PoringH/QCK75-XT/WhatsApp Image 2023-07-01 at 13.19.53.jpg

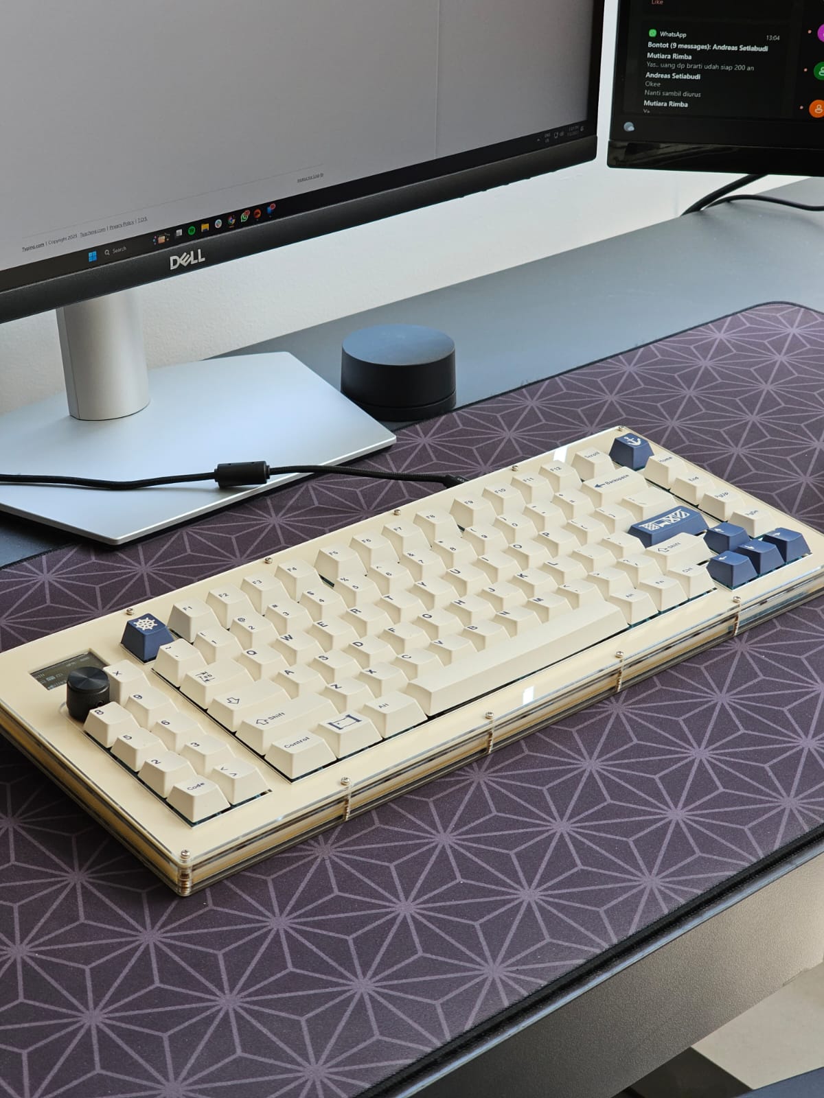
WhatsApp Image 2023-07-01 at 13.19.53.jpg
