PoringH/QCK75-XT/Photos/673584.jpg

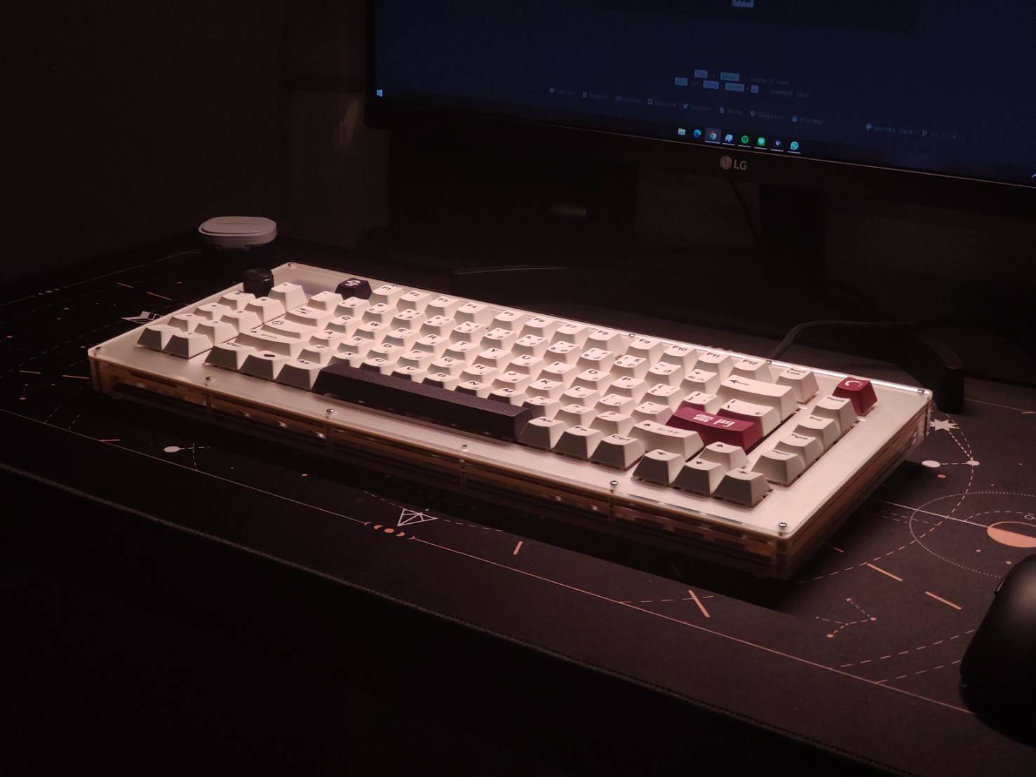
Photos/673584.jpg
