PoringH/QCK75-XT/Photos/673581.jpg

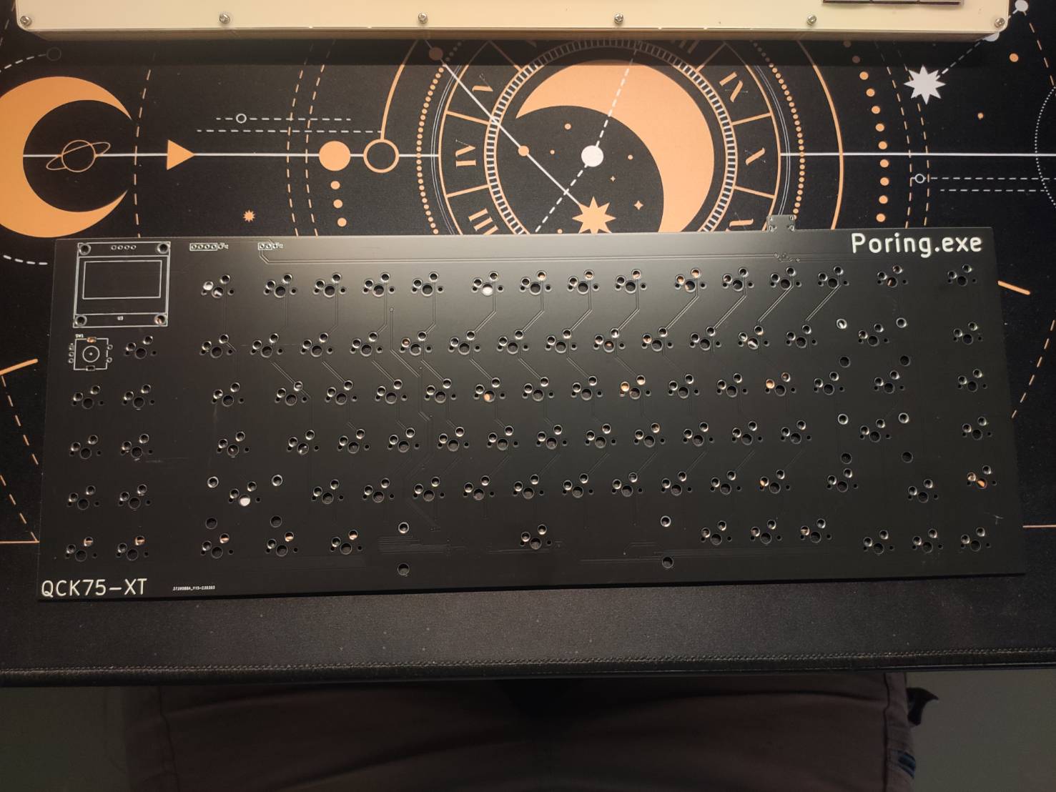
Photos/673581.jpg
