PoringH/QCK75-XT/Photos/673582.jpg

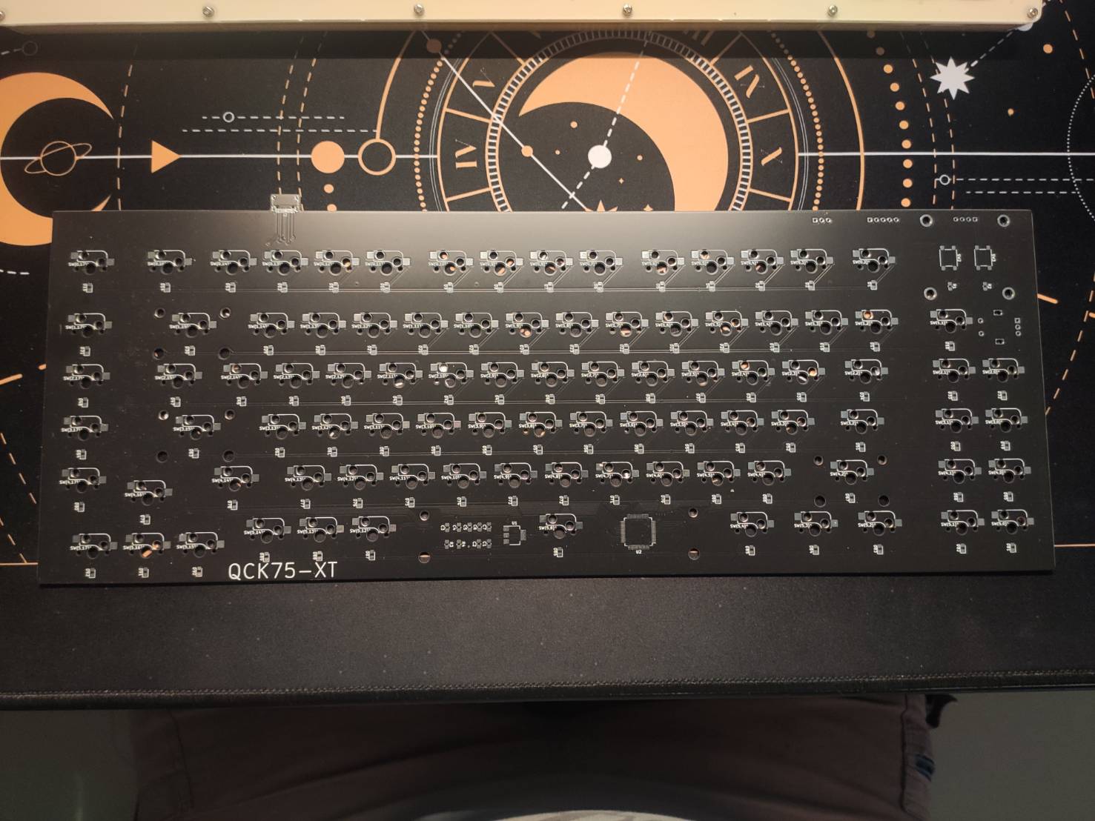
Photos/673582.jpg
