PoringH/QCK75-XT/Photos/673583.jpg

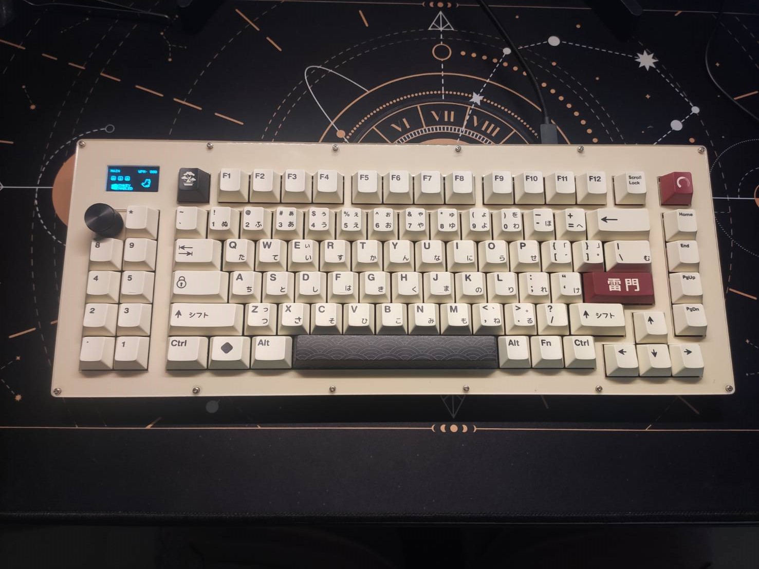
Photos/673583.jpg
