PoringH/QCK75-XT/Photos/673585.jpg

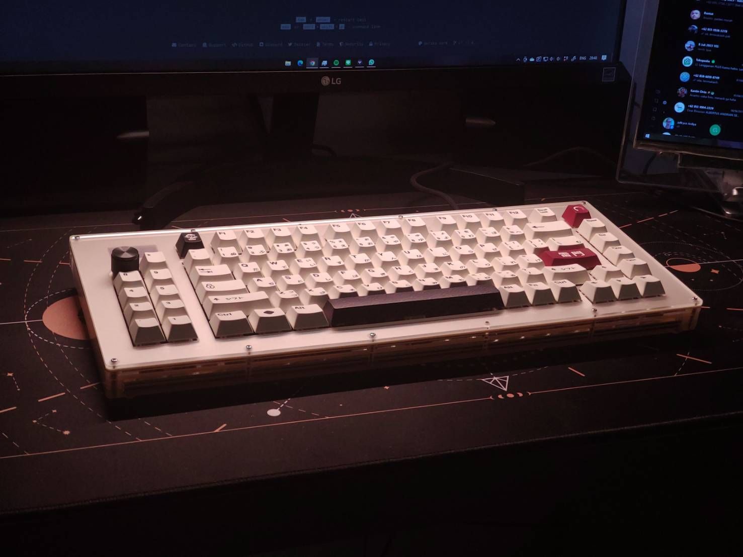
Photos/673585.jpg
