PoringH/QCK75-XT/Photos/673586.jpg

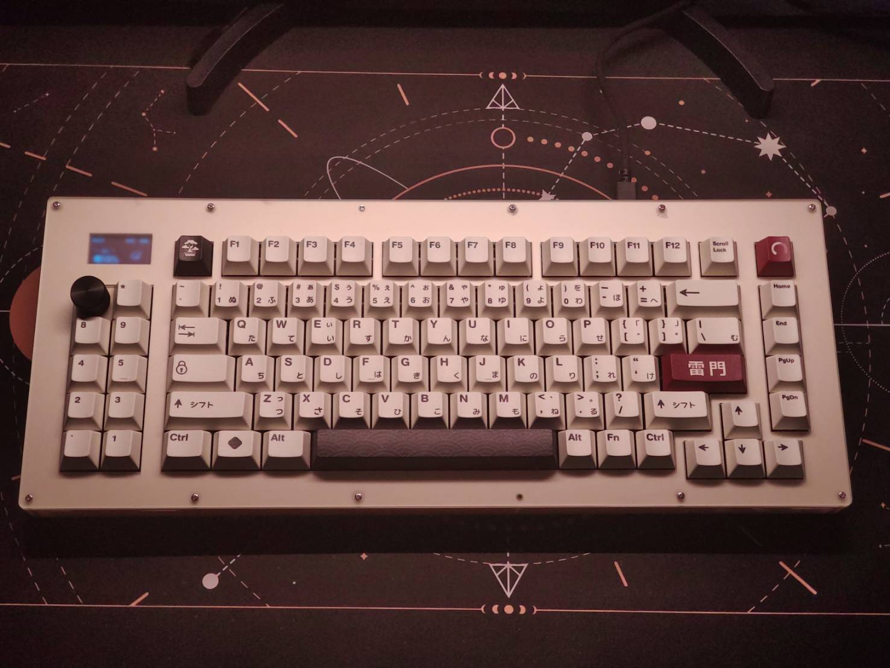
Photos/673586.jpg
