PoringH/QCK75-XT/QCK75 Kicad v2/QCK.csv

Source: | D:\File Andrian\Keeb\QCK75-XT\QCK.kicad_sch
Date: | 20/03/2023 19:50:19
Tool: | Eeschema (6.0.11)
Generator: | C:\Program Files\KiCad\6.0\bin\scripting\plugins/bom_csv_grouped_by_value.py
Component Count: | 208
Individual Components:
Item | Qty | Reference(s) | Value | LibPart | Footprint | Datasheet
 |  | C1 | 100nF | Device:C | Capacitor_SMD:C_0805_2012Metric_Pad1.18x1.45mm_HandSolder | ~
 |  | C2 | 10uF | Device:C | Capacitor_SMD:C_0805_2012Metric_Pad1.18x1.45mm_HandSolder | ~
 |  | C3 | 4.7uF | Device:C | Capacitor_SMD:C_0805_2012Metric_Pad1.18x1.45mm_HandSolder | ~
 |  | C4 | 100nF | Device:C | Capacitor_SMD:C_0805_2012Metric_Pad1.18x1.45mm_HandSolder | ~
 |  | C5 | 100nF | Device:C | Capacitor_SMD:C_0805_2012Metric_Pad1.18x1.45mm_HandSolder | ~
 |  | C6 | 100nF | Device:C | Capacitor_SMD:C_0805_2012Metric_Pad1.18x1.45mm_HandSolder | ~
 |  | C7 | 100nF | Device:C | Capacitor_SMD:C_0805_2012Metric_Pad1.18x1.45mm_HandSolder | ~
 |  | D1 | D | Device:D | Diode_SMD:D_0805_2012Metric_Pad1.15x1.40mm_HandSolder | ~
 |  | D2 | D | Device:D | Diode_SMD:D_0805_2012Metric_Pad1.15x1.40mm_HandSolder | ~
 |  | D3 | D | Device:D | Diode_SMD:D_0805_2012Metric_Pad1.15x1.40mm_HandSolder | ~
 |  | D4 | D | Device:D | Diode_SMD:D_0805_2012Metric_Pad1.15x1.40mm_HandSolder | ~
 |  | D5 | D | Device:D | Diode_SMD:D_0805_2012Metric_Pad1.15x1.40mm_HandSolder | ~
 |  | D6 | D | Device:D | Diode_SMD:D_0805_2012Metric_Pad1.15x1.40mm_HandSolder | ~
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
 |  | SW(5,13)1 | MX_SW_HS | marbastlib-mx:MX_SW_HS | marbastlib-mx:SW_MX_HS_1u | ~
 |  | SW(5,14)1 | MX_SW_HS | marbastlib-mx:MX_SW_HS | marbastlib-mx:SW_MX_HS_1u | ~
 |  | SW(5,15)1 | MX_SW_HS | marbastlib-mx:MX_SW_HS | marbastlib-mx:SW_MX_HS_1u | ~
 |  | SW(5,16)1 | MX_SW_HS | marbastlib-mx:MX_SW_HS | marbastlib-mx:SW_MX_HS_1u | ~
 |  | SW(5,17)1 | MX_SW_HS | marbastlib-mx:MX_SW_HS | marbastlib-mx:SW_MX_HS_1u | ~
 |  | U1 | AMS1117-3.3 | Regulator_Linear:AMS1117-3.3 | Package_TO_SOT_SMD:SOT-223-3_TabPin2 | http://www.advanced-monolithic.com/pdf/ds1117.pdf
 |  | U2 | STM32F072R8Tx | MCU_ST_STM32F0:STM32F072R8Tx | Package_QFP:LQFP-64_10x10mm_P0.5mm | http://www.st.com/st-web-ui/static/active/en/resource/technical/document/datasheet/DM00090510.pdf
 |  | U3 | SSD1306_128X64 | marbastlib-mx:SSD1306_128X64 | marbastlib-mx:SSD1306_128X64
Collated Components:
Item | Qty | Reference(s) | Value | LibPart | Footprint | Datasheet
1 | 5 | C1, C4, C5, C6, C7 | 100nF | Device:C | Capacitor_SMD:C_0805_2012Metric_Pad1.18x1.45mm_HandSolder | ~
2 | 1 | C2 | 10uF | Device:C | Capacitor_SMD:C_0805_2012Metric_Pad1.18x1.45mm_HandSolder | ~
3 | 1 | C3 | 4.7uF | Device:C | Capacitor_SMD:C_0805_2012Metric_Pad1.18x1.45mm_HandSolder | ~
4 | 92 | D1, D2, D3, D4, D5, D6, D7, D8, D9, D10, D11, D12, D13, D14, D15, D16, D17, D18, D19, D20, D21, D22, D23, D24, D25, D26, D27, D28, D29, D30, D31, D32, D33, D34, D35, D36, D37, D38, D39, D40, D41, D42, D43, D44, D45, D46, D47, D48, D49, D50, D51, D52, D53, D54, D55, D56, D57, D58, D59, D60, D61, D62, D63, D64, D65, D66, D67, D68, D69, D70, D71, D72, D73, D74, D75, D76, D77, D78, D79, D80, D81, D82, D83, D84, D85, D86, D87, D88, D89, D90, D91, D92 | D | Device:D | Diode_SMD:D_0805_2012Metric_Pad1.15x1.40mm_HandSolder | ~
5 | 1 | J1 | Conn_01x05_Female | Connector:Conn_01x05_Female | Connector_PinHeader_2.54mm:PinHeader_1x05_P2.54mm_Vertical | ~
6 | 1 | J2 | USB_C_Receptacle_USB2.0 | Connector:USB_C_Receptacle_USB2.0 | Connector_USB:USB_C_Receptacle_HRO_TYPE-C-31-M-12 | https://www.usb.org/sites/default/files/documents/usb_type-c.zip
7 | 1 | J3 | Conn_01x03_Female | Connector:Conn_01x03_Female | Connector_PinHeader_2.54mm:PinHeader_1x03_P2.54mm_Vertical | ~
8 | 4 | R1, R2, R3, R4 | 5.1k | Device:R | Resistor_SMD:R_0805_2012Metric_Pad1.20x1.40mm_HandSolder | ~
9 | 1 | S(1,15)1 | MX_stab | marbastlib-mx:MX_stab | marbastlib-mx:STAB_MX_P_2u
10 | 2 | S(3,15)1, S(4,2)1 | MX_stab | marbastlib-mx:MX_stab | marbastlib-mx:STAB_MX_P_2.25u
11 | 1 | S(5,8)1 | MX_stab | marbastlib-mx:MX_stab | marbastlib-mx:STAB_MX_P_6.25u
12 | 1 | SW1 | RotaryEncoder_Switch | Device:RotaryEncoder_Switch | Rotary_Encoder:RotaryEncoder_Alps_EC11E-Switch_Vertical_H20mm | ~
13 | 2 | SW2, SW3 | SW_Push | Switch:SW_Push | Button_Switch_SMD:SW_Push_1P1T_NO_6x6mm_H9.5mm | ~
14 | 85 | SW(0,2)1, SW(0,3)1, SW(0,4)1, SW(0,5)1, SW(0,6)1, SW(0,7)1, SW(0,8)1, SW(0,9)1, SW(0,10)1, SW(0,11)1, SW(0,12)1, SW(0,13)1, SW(0,14)1, SW(0,16)1, SW(0,17)1, SW(1,1)1, SW(1,2)1, SW(1,3)1, SW(1,4)1, SW(1,5)1, SW(1,6)1, SW(1,7)1, SW(1,8)1, SW(1,9)1, SW(1,10)1, SW(1,11)1, SW(1,12)1, SW(1,13)1, SW(1,14)1, SW(1,15)1, SW(1,17)1, SW(2,0)1, SW(2,1)1, SW(2,3)1, SW(2,4)1, SW(2,5)1, SW(2,6)1, SW(2,7)1, SW(2,8)1, SW(2,9)1, SW(2,10)1, SW(2,11)1, SW(2,12)1, SW(2,13)1, SW(2,14)1, SW(2,17)1, SW(3,0)1, SW(3,1)1, SW(3,3)1, SW(3,4)1, SW(3,5)1, SW(3,6)1, SW(3,7)1, SW(3,8)1, SW(3,9)1, SW(3,10)1, SW(3,11)1, SW(3,12)1, SW(3,13)1, SW(3,15)1, SW(3,17)1, SW(4,0)1, SW(4,1)1, SW(4,2)1, SW(4,4)1, SW(4,5)1, SW(4,6)1, SW(4,7)1, SW(4,8)1, SW(4,9)1, SW(4,10)1, SW(4,11)1, SW(4,12)1, SW(4,13)1, SW(4,16)1, SW(4,17)1, SW(5,0)1, SW(5,1)1, SW(5,8)1, SW(5,12)1, SW(5,13)1, SW(5,14)1, SW(5,15)1, SW(5,16)1, SW(5,17)1 | MX_SW_HS | marbastlib-mx:MX_SW_HS | marbastlib-mx:SW_MX_HS_1u | ~
15 | 2 | SW(2,2)1, SW(2,15)1 | MX_SW_HS | marbastlib-mx:MX_SW_HS | marbastlib-mx:SW_MX_HS_1.5u | ~
16 | 2 | SW(3,2)1, SW(4,14)1 | MX_SW_HS | marbastlib-mx:MX_SW_HS | marbastlib-mx:SW_MX_HS_1.75u | ~
17 | 3 | SW(5,2)1, SW(5,3)1, SW(5,4)1 | MX_SW_HS | marbastlib-mx:MX_SW_HS | marbastlib-mx:SW_MX_HS_1.25u | ~
18 | 1 | U1 | AMS1117-3.3 | Regulator_Linear:AMS1117-3.3 | Package_TO_SOT_SMD:SOT-223-3_TabPin2 | http://www.advanced-monolithic.com/pdf/ds1117.pdf
19 | 1 | U2 | STM32F072R8Tx | MCU_ST_STM32F0:STM32F072R8Tx | Package_QFP:LQFP-64_10x10mm_P0.5mm | http://www.st.com/st-web-ui/static/active/en/resource/technical/document/datasheet/DM00090510.pdf
20 | 1 | U3 | SSD1306_128X64 | marbastlib-mx:SSD1306_128X64 | marbastlib-mx:SSD1306_128X64
