PoringH/QCK75-XT/Freecad/alu case/test.step

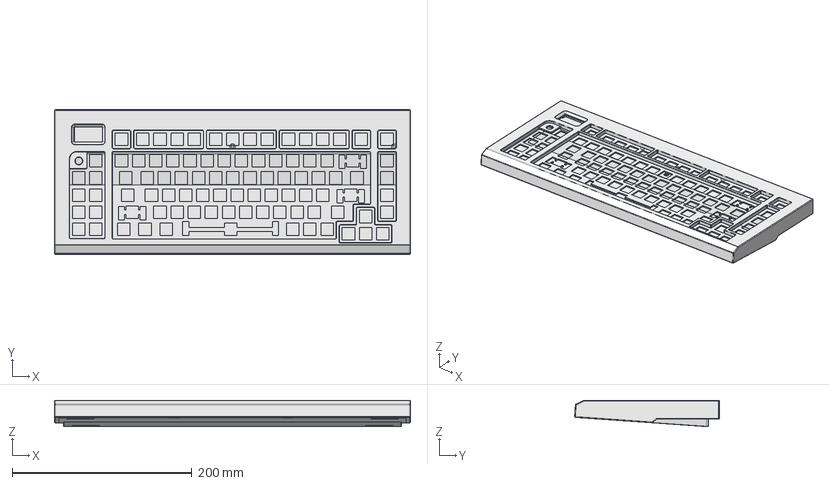
[picture p8: CAD file, 2023-08-31]
Freecad/alu case/test.step
395.9 x 161.1 x 29.4 mm
