PoringH/QCK75-XT/Freecad/pcb.step

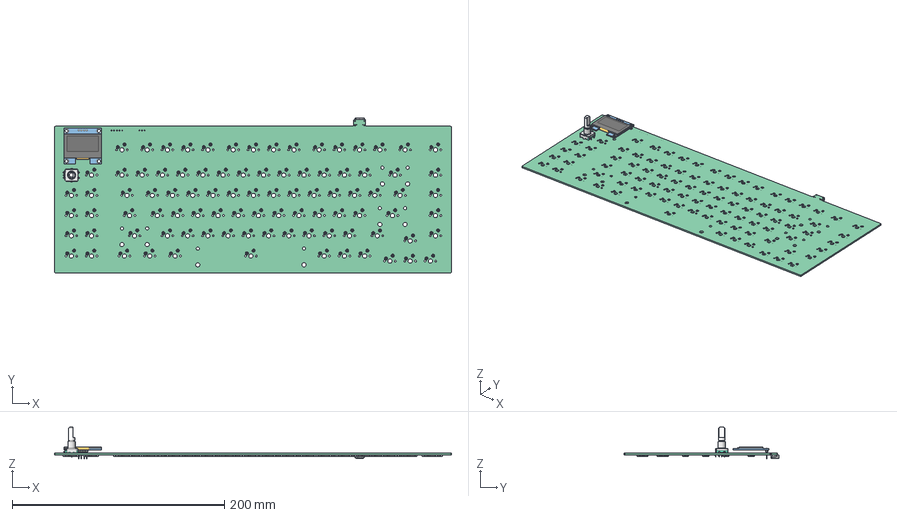
[picture p9: CAD file, 2023-08-31]
Freecad/pcb.step
373.9 x 145.8 x 30.0 mm
Local_CS_c8ce
Pcb_c8ce
PCB_Sketch_c8ce
U3_AZ-Delivery - OLED13 IIC_5770bfb8a0b9
SW1_(Unsaved)_ded8dcd7eb34
Contact x 188
USB_C_Receptacle_16P_TopMnt_Horizontal_GCT_USB4105-xx-A
