PoringH/QCK75-XT/Freecad/alu case/topcase.step

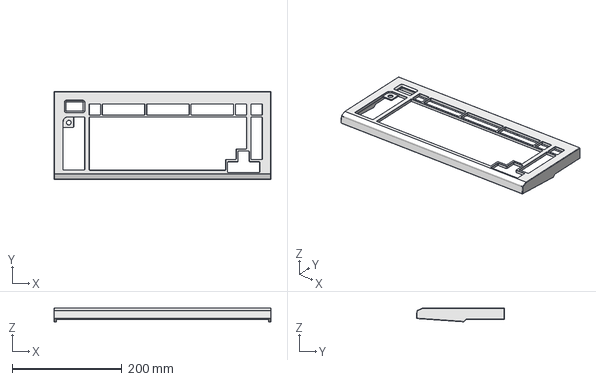
[picture p10: CAD file, 2023-06-27]
Freecad/alu case/topcase.step
395.9 x 161.1 x 25.1 mm
