PoringH/QCK75-XT/Freecad/QCK.FCStd

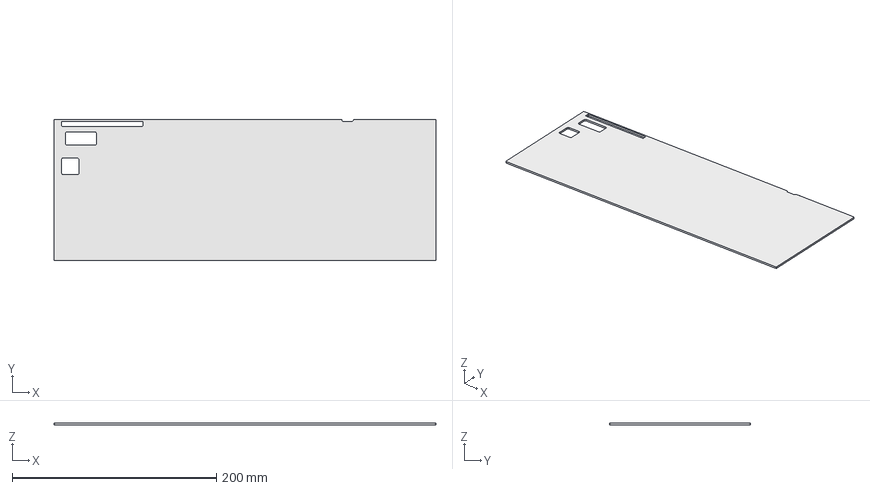
[picture p11: CAD file, 2023-08-31]
Freecad/QCK.FCStd
373.9 x 138.1 x 2.00 mm
