PoringH/QCK75-XT/Freecad/2mm_putih tulang_801.dxf

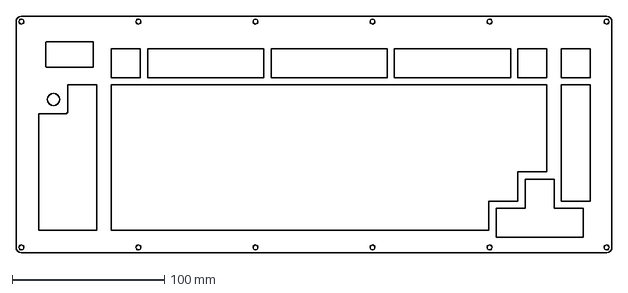
[picture p12: CAD file, 2023-05-16]
Freecad/2mm_putih tulang_801.dxf
390.9 x 155.1 mm
