PoringH/QCK75-XT/Freecad/alu case/weight.step

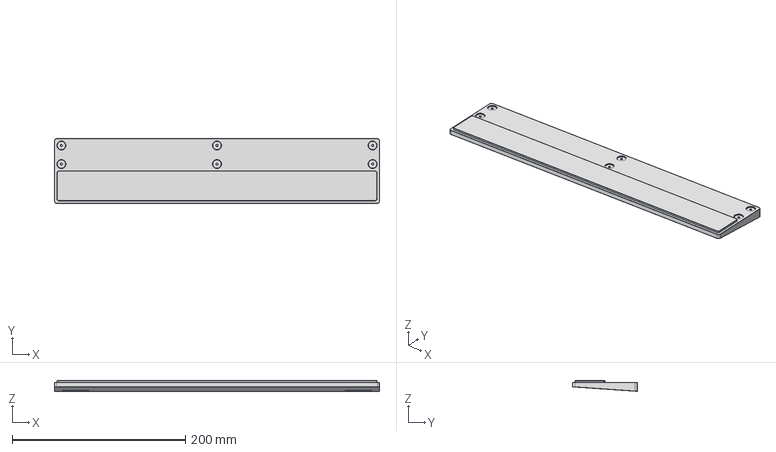
[picture p13: CAD file, 2023-06-27]
Freecad/alu case/weight.step
375.4 x 74.8 x 12.4 mm
