PoringH/QCK75-XT/Freecad/alu case/bottomcase.step

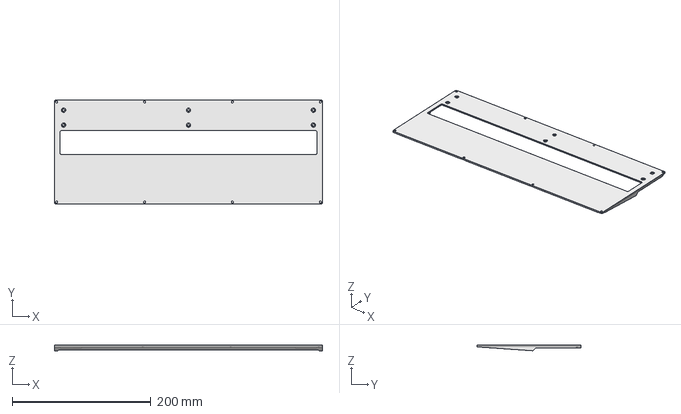
[picture p14: CAD file, 2023-06-27]
Freecad/alu case/bottomcase.step
385.8 x 150.0 x 8.05 mm
