PoringH/QCK75-XT/QCK75 Kicad v2/QCK.kicad_sch

## KiCad design QCK75 Kicad v2/QCK.kicad_sch (2023-03-02)

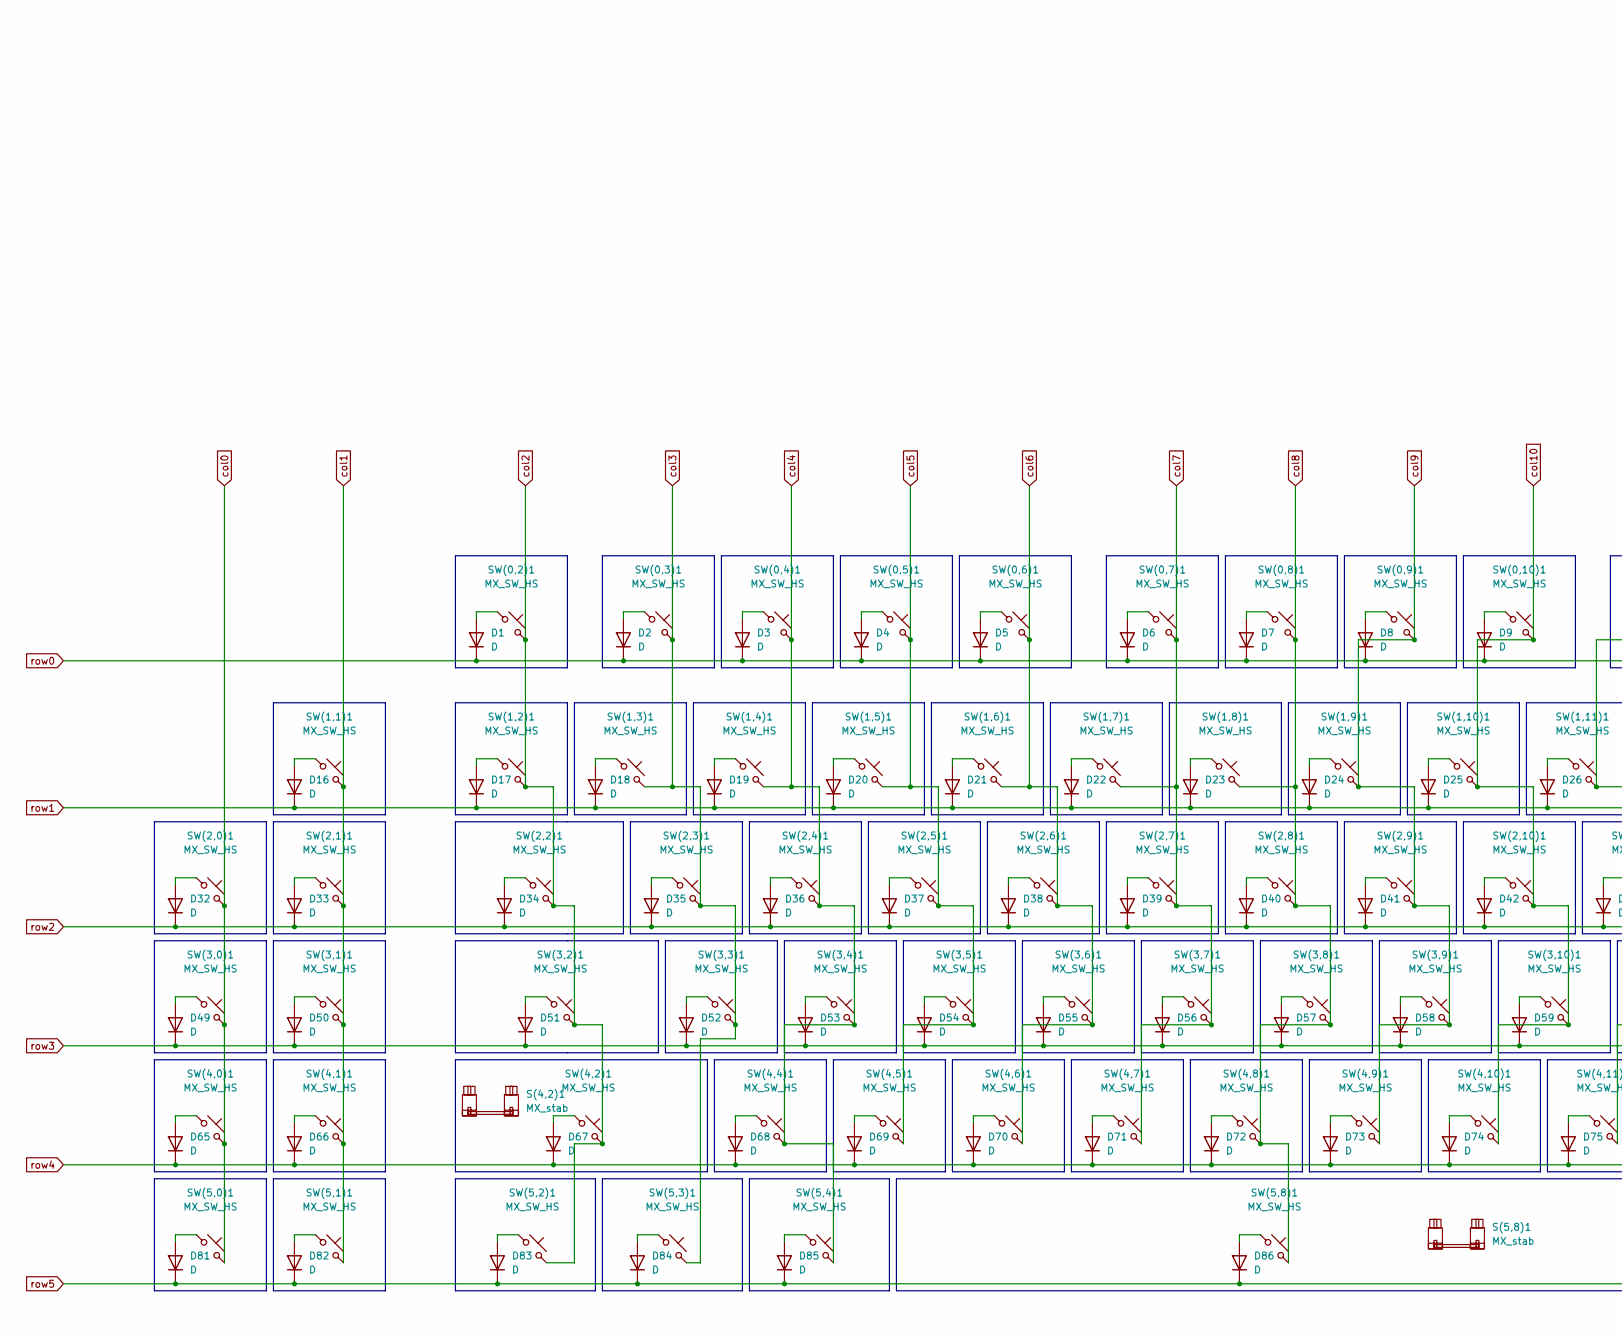
[picture p15: schematic QCK.kicad_sch, part in row 1, column 1]

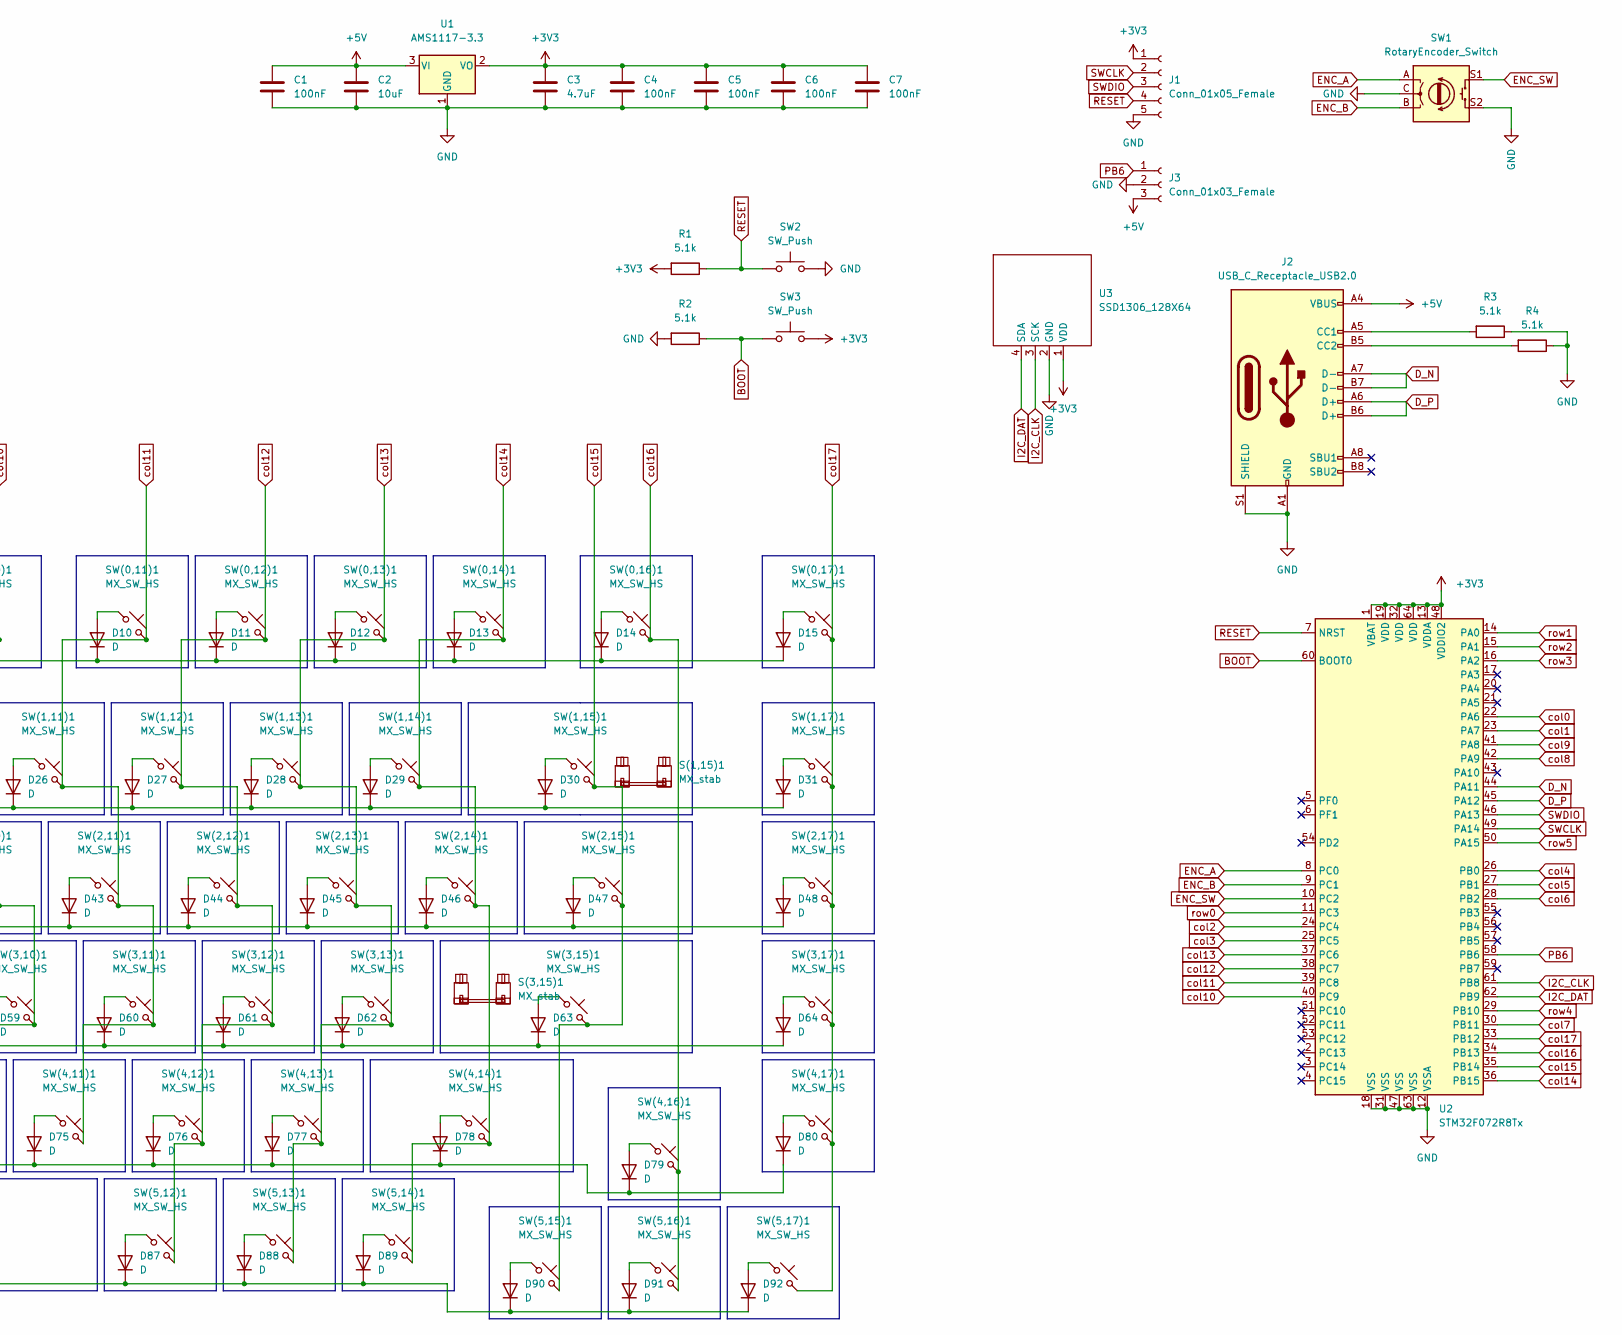
[picture p16: schematic QCK.kicad_sch, part in row 1, column 2]

Parts:
C1, C4, C5, C6, C7: 100nF; C_0805_2012Metric_Pad1.18x1.45mm_HandSolder
C2: 10uF; C_0805_2012Metric_Pad1.18x1.45mm_HandSolder
C3: 4.7uF; C_0805_2012Metric_Pad1.18x1.45mm_HandSolder
D1, D2, D3, D4, D5, D6, D7, D8, D9, D10, D11, D12, D13, D14, D15, D16, D17, D18, D19, D20, D21, D22, D23, D24, D25, D26, D27, D28, D29, D30, D31, D32, D33, D34, D35, D36, D37, D38, D39, D40, D41, D42, D43, D44, D45, D46, D47, D48, D49, D50, D51, D52, D53, D54, D55, D56, D57, D58, D59, D60, D61, D62, D63, D64, D65, D66, D67, D68, D69, D70, D71, D72, D73, D74, D75, D76, D77, D78, D79, D80, D81, D82, D83, D84, D85, D86, D87, D88, D89, D90, D91, D92: D; D_0805_2012Metric_Pad1.15x1.40mm_HandSolder
J1: Conn_01x05_Female; PinHeader_1x05_P2.54mm_Vertical
J2: USB_C_Receptacle_USB2.0; USB_C_Receptacle_HRO_TYPE-C-31-M-12
J3: Conn_01x03_Female; PinHeader_1x03_P2.54mm_Vertical
R1, R2, R3, R4: 5.1k; R_0805_2012Metric_Pad1.20x1.40mm_HandSolder
S(1,15)1: MX_stab; STAB_MX_P_2u
S(3,15)1, S(4,2)1: MX_stab; STAB_MX_P_2.25u
S(5,8)1: MX_stab; STAB_MX_P_6.25u
SW1: RotaryEncoder_Switch; RotaryEncoder_Alps_EC11E-Switch_Vertical_H20mm
SW2, SW3: SW_Push; SW_Push_1P1T_NO_6x6mm_H9.5mm
SW(0,2)1, SW(0,3)1, SW(0,4)1, SW(0,5)1, SW(0,6)1, SW(0,7)1, SW(0,8)1, SW(0,9)1, SW(0,10)1, SW(0,11)1, SW(0,12)1, SW(0,13)1, SW(0,14)1, SW(0,16)1, SW(0,17)1, SW(1,1)1, SW(1,2)1, SW(1,3)1, SW(1,4)1, SW(1,5)1, SW(1,6)1, SW(1,7)1, SW(1,8)1, SW(1,9)1, SW(1,10)1, SW(1,11)1, SW(1,12)1, SW(1,13)1, SW(1,14)1, SW(1,15)1, SW(1,17)1, SW(2,0)1, SW(2,1)1, SW(2,3)1, SW(2,4)1, SW(2,5)1, SW(2,6)1, SW(2,7)1, SW(2,8)1, SW(2,9)1, SW(2,10)1, SW(2,11)1, SW(2,12)1, SW(2,13)1, SW(2,14)1, SW(2,17)1, SW(3,0)1, SW(3,1)1, SW(3,3)1, SW(3,4)1, SW(3,5)1, SW(3,6)1, SW(3,7)1, SW(3,8)1, SW(3,9)1, SW(3,10)1, SW(3,11)1, SW(3,12)1, SW(3,13)1, SW(3,15)1, SW(3,17)1, SW(4,0)1, SW(4,1)1, SW(4,2)1, SW(4,4)1, SW(4,5)1, SW(4,6)1, SW(4,7)1, SW(4,8)1, SW(4,9)1, SW(4,10)1, SW(4,11)1, SW(4,12)1, SW(4,13)1, SW(4,16)1, SW(4,17)1, SW(5,0)1, SW(5,1)1, SW(5,8)1, SW(5,12)1, SW(5,13)1, SW(5,14)1, SW(5,15)1, SW(5,16)1, SW(5,17)1: MX_SW_HS; SW_MX_HS_1u
SW(2,2)1, SW(2,15)1: MX_SW_HS; SW_MX_HS_1.5u
SW(3,2)1, SW(4,14)1: MX_SW_HS; SW_MX_HS_1.75u
SW(5,2)1, SW(5,3)1, SW(5,4)1: MX_SW_HS; SW_MX_HS_1.25u
U1: AMS1117-3.3; SOT-223-3_TabPin2
U2: STM32F072R8Tx; LQFP-64_10x10mm_P0.5mm
U3: SSD1306_128X64

Connections:
+3V3: C3.1, C4.1, C5.1, C6.1, C7.1, J1.1, R1.2, SW3.2, U1.2 (VO), U2.1 (VBAT), U2.13 (VDDA), U2.19 (VDD), U2.32 (VDD), U2.48 (VDDIO2), U2.64 (VDD), U3.1 (VDD)
+5V: C1.1, C2.1, J2.A4 (VBUS), J2.A9 (VBUS), J2.B4 (VBUS), J2.B9 (VBUS), J3.3, U1.3 (VI)
BOOT: R2.1, SW3.1, U2.60 (BOOT0)
D_N: J2.A7 (D-), J2.B7 (D-), U2.44 (PA11)
D_P: J2.A6 (D+), J2.B6 (D+), U2.45 (PA12)
ENC_A: SW1.A, U2.8 (PC0)
ENC_B: SW1.B, U2.9 (PC1)
ENC_SW: SW1.S1, U2.10 (PC2)
GND: C1.2, C2.2, C3.2, C4.2, C5.2, C6.2, C7.2, J1.5, J2.A1 (GND), J2.A12 (GND), J2.B1 (GND), J2.B12 (GND), J2.S1 (SHIELD), J3.2, R2.2, R3.1, R4.1, SW1.C, SW1.S2, SW2.2, U1.1 (GND), U2.12 (VSSA), U2.18 (VSS), U2.31 (VSS), U2.47 (VSS), U2.63 (VSS), U3.2 (GND)
I2C_CLK: U2.61 (PB8), U3.3 (SCK)
I2C_DAT: U2.62 (PB9), U3.4 (SDA)
unnamed: D1.2 (A), SW(0,2)1.1
unnamed: D2.2 (A), SW(0,3)1.1
unnamed: D3.2 (A), SW(0,4)1.1
unnamed: D4.2 (A), SW(0,5)1.1
unnamed: D5.2 (A), SW(0,6)1.1
unnamed: D6.2 (A), SW(0,7)1.1
unnamed: D7.2 (A), SW(0,8)1.1
unnamed: D8.2 (A), SW(0,9)1.1
unnamed: D9.2 (A), SW(0,10)1.1
unnamed: D10.2 (A), SW(0,11)1.1
unnamed: D11.2 (A), SW(0,12)1.1
unnamed: D12.2 (A), SW(0,13)1.1
unnamed: D13.2 (A), SW(0,14)1.1
unnamed: D14.2 (A), SW(0,16)1.1
unnamed: D15.2 (A), SW(0,17)1.1
unnamed: D16.2 (A), SW(1,1)1.1
unnamed: D17.2 (A), SW(1,2)1.1
unnamed: D18.2 (A), SW(1,3)1.1
unnamed: D19.2 (A), SW(1,4)1.1
unnamed: D20.2 (A), SW(1,5)1.1
unnamed: D21.2 (A), SW(1,6)1.1
unnamed: D22.2 (A), SW(1,7)1.1
unnamed: D23.2 (A), SW(1,8)1.1
unnamed: D24.2 (A), SW(1,9)1.1
unnamed: D25.2 (A), SW(1,10)1.1
unnamed: D26.2 (A), SW(1,11)1.1
unnamed: D27.2 (A), SW(1,12)1.1
unnamed: D28.2 (A), SW(1,13)1.1
unnamed: D29.2 (A), SW(1,14)1.1
unnamed: D30.2 (A), SW(1,15)1.1
unnamed: D31.2 (A), SW(1,17)1.1
unnamed: D32.2 (A), SW(2,0)1.1
unnamed: D33.2 (A), SW(2,1)1.1
unnamed: D34.2 (A), SW(2,2)1.1
unnamed: D35.2 (A), SW(2,3)1.1
unnamed: D36.2 (A), SW(2,4)1.1
unnamed: D37.2 (A), SW(2,5)1.1
unnamed: D38.2 (A), SW(2,6)1.1
unnamed: D39.2 (A), SW(2,7)1.1
unnamed: D40.2 (A), SW(2,8)1.1
unnamed: D41.2 (A), SW(2,9)1.1
unnamed: D42.2 (A), SW(2,10)1.1
unnamed: D43.2 (A), SW(2,11)1.1
unnamed: D44.2 (A), SW(2,12)1.1
unnamed: D45.2 (A), SW(2,13)1.1
unnamed: D46.2 (A), SW(2,14)1.1
unnamed: D47.2 (A), SW(2,15)1.1
unnamed: D48.2 (A), SW(2,17)1.1
unnamed: D49.2 (A), SW(3,0)1.1
unnamed: D50.2 (A), SW(3,1)1.1
unnamed: D51.2 (A), SW(3,2)1.1
unnamed: D52.2 (A), SW(3,3)1.1
unnamed: D53.2 (A), SW(3,4)1.1
unnamed: D54.2 (A), SW(3,5)1.1
unnamed: D55.2 (A), SW(3,6)1.1
unnamed: D56.2 (A), SW(3,7)1.1
unnamed: D57.2 (A), SW(3,8)1.1
unnamed: D58.2 (A), SW(3,9)1.1
unnamed: D59.2 (A), SW(3,10)1.1
unnamed: D60.2 (A), SW(3,11)1.1
unnamed: D61.2 (A), SW(3,12)1.1
unnamed: D62.2 (A), SW(3,13)1.1
unnamed: D63.2 (A), SW(3,15)1.1
unnamed: D64.2 (A), SW(3,17)1.1
unnamed: D65.2 (A), SW(4,0)1.1
unnamed: D66.2 (A), SW(4,1)1.1
unnamed: D67.2 (A), SW(4,2)1.1
unnamed: D68.2 (A), SW(4,4)1.1
unnamed: D69.2 (A), SW(4,5)1.1
unnamed: D70.2 (A), SW(4,6)1.1
unnamed: D71.2 (A), SW(4,7)1.1
unnamed: D72.2 (A), SW(4,8)1.1
unnamed: D73.2 (A), SW(4,9)1.1
unnamed: D74.2 (A), SW(4,10)1.1
unnamed: D75.2 (A), SW(4,11)1.1
unnamed: D76.2 (A), SW(4,12)1.1
unnamed: D77.2 (A), SW(4,13)1.1
unnamed: D78.2 (A), SW(4,14)1.1
unnamed: D79.2 (A), SW(4,16)1.1
unnamed: D80.2 (A), SW(4,17)1.1
unnamed: D81.2 (A), SW(5,0)1.1
unnamed: D82.2 (A), SW(5,1)1.1
unnamed: D83.2 (A), SW(5,2)1.1
unnamed: D84.2 (A), SW(5,3)1.1
unnamed: D85.2 (A), SW(5,4)1.1
unnamed: D86.2 (A), SW(5,8)1.1
unnamed: D87.2 (A), SW(5,12)1.1
unnamed: D88.2 (A), SW(5,13)1.1
unnamed: D89.2 (A), SW(5,14)1.1
unnamed: D90.2 (A), SW(5,15)1.1
unnamed: D91.2 (A), SW(5,16)1.1
unnamed: D92.2 (A), SW(5,17)1.1
unnamed: J2.A5 (CC1), R3.2
unnamed: J2.B5 (CC2), R4.2
PB6: J3.1, U2.58 (PB6)
RESET: J1.4, R1.1, SW2.1, U2.7 (NRST)
SWCLK: J1.2, U2.49 (PA14)
SWDIO: J1.3, U2.46 (PA13)
col0: SW(2,0)1.2, SW(3,0)1.2, SW(4,0)1.2, SW(5,0)1.2, U2.22 (PA6)
col1: SW(1,1)1.2, SW(2,1)1.2, SW(3,1)1.2, SW(4,1)1.2, SW(5,1)1.2, U2.23 (PA7)
col2: SW(0,2)1.2, SW(1,2)1.2, SW(2,2)1.2, SW(3,2)1.2, SW(4,2)1.2, SW(5,2)1.2, U2.24 (PC4)
col3: SW(0,3)1.2, SW(1,3)1.2, SW(2,3)1.2, SW(3,3)1.2, SW(5,3)1.2, U2.25 (PC5)
col4: SW(0,4)1.2, SW(1,4)1.2, SW(2,4)1.2, SW(3,4)1.2, SW(4,4)1.2, SW(5,4)1.2, U2.26 (PB0)
col5: SW(0,5)1.2, SW(1,5)1.2, SW(2,5)1.2, SW(3,5)1.2, SW(4,5)1.2, U2.27 (PB1)
col6: SW(0,6)1.2, SW(1,6)1.2, SW(2,6)1.2, SW(3,6)1.2, SW(4,6)1.2, U2.28 (PB2)
col7: SW(0,7)1.2, SW(1,7)1.2, SW(2,7)1.2, SW(3,7)1.2, SW(4,7)1.2, U2.30 (PB11)
col8: SW(0,8)1.2, SW(1,8)1.2, SW(2,8)1.2, SW(3,8)1.2, SW(4,8)1.2, SW(5,8)1.2, U2.42 (PA9)
col9: SW(0,9)1.2, SW(1,9)1.2, SW(2,9)1.2, SW(3,9)1.2, SW(4,9)1.2, U2.41 (PA8)
col10: SW(0,10)1.2, SW(1,10)1.2, SW(2,10)1.2, SW(3,10)1.2, SW(4,10)1.2, U2.40 (PC9)
col11: SW(0,11)1.2, SW(1,11)1.2, SW(2,11)1.2, SW(3,11)1.2, SW(4,11)1.2, U2.39 (PC8)
col12: SW(0,12)1.2, SW(1,12)1.2, SW(2,12)1.2, SW(3,12)1.2, SW(4,12)1.2, SW(5,12)1.2, U2.38 (PC7)
col13: SW(0,13)1.2, SW(1,13)1.2, SW(2,13)1.2, SW(3,13)1.2, SW(4,13)1.2, SW(5,13)1.2, U2.37 (PC6)
col14: SW(0,14)1.2, SW(1,14)1.2, SW(2,14)1.2, SW(4,14)1.2, SW(5,14)1.2, U2.36 (PB15)
col15: SW(1,15)1.2, SW(2,15)1.2, SW(3,15)1.2, SW(5,15)1.2, U2.35 (PB14)
col16: SW(0,16)1.2, SW(4,16)1.2, SW(5,16)1.2, U2.34 (PB13)
col17: SW(0,17)1.2, SW(1,17)1.2, SW(2,17)1.2, SW(3,17)1.2, SW(4,17)1.2, SW(5,17)1.2, U2.33 (PB12)
row0: D1.1 (K), D2.1 (K), D3.1 (K), D4.1 (K), D5.1 (K), D6.1 (K), D7.1 (K), D8.1 (K), D9.1 (K), D10.1 (K), D11.1 (K), D12.1 (K), D13.1 (K), D14.1 (K), D15.1 (K), U2.11 (PC3)
row1: D16.1 (K), D17.1 (K), D18.1 (K), D19.1 (K), D20.1 (K), D21.1 (K), D22.1 (K), D23.1 (K), D24.1 (K), D25.1 (K), D26.1 (K), D27.1 (K), D28.1 (K), D29.1 (K), D30.1 (K), D31.1 (K), U2.14 (PA0)
row2: D32.1 (K), D33.1 (K), D34.1 (K), D35.1 (K), D36.1 (K), D37.1 (K), D38.1 (K), D39.1 (K), D40.1 (K), D41.1 (K), D42.1 (K), D43.1 (K), D44.1 (K), D45.1 (K), D46.1 (K), D47.1 (K), D48.1 (K), U2.15 (PA1)
row3: D49.1 (K), D50.1 (K), D51.1 (K), D52.1 (K), D53.1 (K), D54.1 (K), D55.1 (K), D56.1 (K), D57.1 (K), D58.1 (K), D59.1 (K), D60.1 (K), D61.1 (K), D62.1 (K), D63.1 (K), D64.1 (K), U2.16 (PA2)
row4: D65.1 (K), D66.1 (K), D67.1 (K), D68.1 (K), D69.1 (K), D70.1 (K), D71.1 (K), D72.1 (K), D73.1 (K), D74.1 (K), D75.1 (K), D76.1 (K), D77.1 (K), D78.1 (K), D79.1 (K), D80.1 (K), U2.29 (PB10)
row5: D81.1 (K), D82.1 (K), D83.1 (K), D84.1 (K), D85.1 (K), D86.1 (K), D87.1 (K), D88.1 (K), D89.1 (K), D90.1 (K), D91.1 (K), D92.1 (K), U2.50 (PA15)
