PoringH/QCK75-XT/Firmware/qck75/v1/keymaps/via/keymap.c

// Copyright 2023 QMK
// SPDX-License-Identifier: GPL-2.0-or-later

#include QMK_KEYBOARD_H

const uint16_t PROGMEM keymaps[][MATRIX_ROWS][MATRIX_COLS] = {
    [0] = LAYOUT_75_ansi(
        				  KC_ESC,  KC_F1,   KC_F2,   KC_F3, KC_F4, KC_F5,   KC_F6, 	KC_F7, KC_F8,   KC_F9, 	 KC_F10,  KC_F11,  KC_F12,  KC_F13,  KC_DEL, 
				 KC_MPLY, KC_GRV,  KC_1, 	KC_2,    KC_3,  KC_4,  KC_5, 	KC_6, 	KC_7,  KC_8, 	KC_9, 	 KC_0, 	  KC_MINS, KC_EQL,  KC_BSPC, KC_HOME, 
		KC_MPRV, KC_MNXT, KC_TAB,  KC_Q, 	KC_W,    KC_E,  KC_R,  KC_T, 	KC_Y, 	KC_U,  KC_I,	KC_O, 	 KC_P, 	  KC_LBRC, KC_RBRC, KC_BSLS, KC_END, 
		KC_F17,  KC_F18,  KC_CAPS, KC_A, 	KC_S,    KC_D,  KC_F,  KC_G, 	KC_H, 	KC_J,  KC_K,	KC_L, 	 KC_SCLN, KC_QUOT, KC_ENT, 			 KC_PGUP, 
		KC_F19,  KC_F20,  KC_LSFT, KC_Z,	KC_X,    KC_C,  KC_V,  KC_B, 	KC_N, 	KC_M,  KC_COMM, KC_DOT,  KC_SLSH, KC_RSFT, 		    KC_UP, 	 KC_PGDN, 
		KC_F21,  KC_F22,  KC_LCTL, KC_LGUI, KC_LALT, 						KC_SPC, 				KC_RALT, MO(1),   KC_RCTL, KC_LEFT, KC_DOWN, KC_RGHT
    ),
    [1] = LAYOUT_75_ansi(
       			 		  KC_TRNS, KC_TRNS, KC_TRNS, KC_TRNS, KC_TRNS, KC_TRNS, KC_TRNS, KC_TRNS, KC_TRNS, KC_TRNS, KC_TRNS, KC_TRNS, KC_TRNS, KC_TRNS, KC_TRNS, 
				 KC_TRNS, KC_TRNS, KC_TRNS, KC_TRNS, KC_TRNS, KC_TRNS, KC_TRNS, KC_TRNS, KC_TRNS, KC_TRNS, KC_TRNS, KC_TRNS, KC_TRNS, KC_TRNS, KC_TRNS, KC_TRNS, 
		KC_TRNS, KC_TRNS, KC_TRNS, KC_TRNS, KC_TRNS, KC_TRNS, KC_TRNS, KC_TRNS, KC_TRNS, KC_TRNS, KC_TRNS, KC_TRNS, KC_TRNS, KC_TRNS, KC_TRNS, KC_TRNS, KC_TRNS, 
		KC_TRNS, KC_TRNS, KC_TRNS, KC_TRNS, KC_TRNS, KC_TRNS, KC_TRNS, KC_TRNS, KC_TRNS, KC_TRNS, KC_TRNS, KC_TRNS, KC_TRNS, KC_TRNS, KC_TRNS, 		 	KC_TRNS, 
		KC_TRNS, KC_TRNS, KC_TRNS, KC_TRNS,	KC_TRNS, KC_TRNS, KC_TRNS, KC_TRNS, KC_TRNS, KC_TRNS, KC_TRNS, KC_TRNS, KC_TRNS, KC_TRNS, 		   KC_TRNS, KC_TRNS, 
		KC_TRNS, KC_TRNS, KC_TRNS, GU_TOGG, KC_TRNS, 							KC_TRNS, 				  	MO(2), KC_TRNS, KC_TRNS,  KC_TRNS, KC_TRNS, KC_TRNS
    ),
    [2] = LAYOUT_75_ansi(
       			 		  KC_TRNS, KC_TRNS, KC_TRNS, KC_TRNS, KC_TRNS, KC_TRNS, KC_TRNS, KC_TRNS, KC_TRNS, KC_TRNS, KC_TRNS, KC_TRNS, KC_TRNS, KC_TRNS, KC_TRNS, 
				 KC_TRNS, KC_TRNS, KC_TRNS, KC_TRNS, KC_TRNS, KC_TRNS, KC_TRNS, KC_TRNS, KC_TRNS, KC_TRNS, KC_TRNS, KC_TRNS, KC_TRNS, KC_TRNS, KC_TRNS, KC_TRNS, 
		KC_TRNS, KC_TRNS, KC_TRNS, KC_TRNS, KC_TRNS, KC_TRNS, KC_TRNS, KC_TRNS, KC_TRNS, KC_TRNS, KC_TRNS, KC_TRNS, KC_TRNS, KC_TRNS, KC_TRNS, KC_TRNS, KC_TRNS, 
		KC_TRNS, KC_TRNS, KC_TRNS, KC_TRNS, KC_TRNS, KC_TRNS, KC_TRNS, KC_TRNS, KC_TRNS, KC_TRNS, KC_TRNS, KC_TRNS, KC_TRNS, KC_TRNS, KC_TRNS, 		 	KC_TRNS, 
		KC_TRNS, KC_TRNS, KC_TRNS, KC_TRNS,	KC_TRNS, KC_TRNS, KC_TRNS, KC_TRNS, KC_TRNS, KC_TRNS, KC_TRNS, KC_TRNS, KC_TRNS, KC_TRNS, 		   KC_TRNS, KC_TRNS, 
		KC_TRNS, KC_TRNS, KC_TRNS, KC_TRNS, KC_TRNS, 							KC_TRNS, 				  	KC_TRNS, KC_TRNS, MO(3), KC_TRNS,  KC_TRNS, KC_TRNS
    ),
    [3] = LAYOUT_75_ansi(
       			 		  KC_TRNS, KC_TRNS, KC_TRNS, KC_TRNS, KC_TRNS, KC_TRNS, KC_TRNS, KC_TRNS, KC_TRNS, KC_TRNS, KC_TRNS, KC_TRNS, KC_TRNS, KC_TRNS, KC_TRNS, 
				 KC_TRNS, KC_TRNS, KC_TRNS, KC_TRNS, KC_TRNS, KC_TRNS, KC_TRNS, KC_TRNS, KC_TRNS, KC_TRNS, KC_TRNS, KC_TRNS, KC_TRNS, KC_TRNS, KC_TRNS, KC_TRNS, 
		KC_TRNS, KC_TRNS, KC_TRNS, KC_TRNS, KC_TRNS, KC_TRNS, KC_TRNS, KC_TRNS, KC_TRNS, KC_TRNS, KC_TRNS, KC_TRNS, KC_TRNS, KC_TRNS, KC_TRNS, KC_TRNS, KC_TRNS, 
		KC_TRNS, KC_TRNS, KC_TRNS, KC_TRNS, KC_TRNS, KC_TRNS, KC_TRNS, KC_TRNS, KC_TRNS, KC_TRNS, KC_TRNS, KC_TRNS, KC_TRNS, KC_TRNS, KC_TRNS, 		 	KC_TRNS, 
		KC_TRNS, KC_TRNS, KC_TRNS, KC_TRNS,	KC_TRNS, KC_TRNS, KC_TRNS, KC_TRNS, KC_TRNS, KC_TRNS, KC_TRNS, KC_TRNS, KC_TRNS, KC_TRNS, 		   KC_TRNS, KC_TRNS, 
		QK_BOOT, NK_TOGG, KC_TRNS, KC_TRNS, KC_TRNS, 							KC_TRNS, 				   KC_TRNS, KC_TRNS, KC_TRNS, KC_TRNS, KC_TRNS, KC_TRNS
    )
};

#if defined(ENCODER_MAP_ENABLE)

const uint16_t PROGMEM encoder_map[][1][2] = {
	[0] = {ENCODER_CCW_CW(KC_VOLD, KC_VOLU)},
	[1] = {ENCODER_CCW_CW(KC_MPRV, KC_MNXT)},
	[2] = {ENCODER_CCW_CW(KC_MS_L, KC_MS_R)},
	[3] = {ENCODER_CCW_CW(KC_MS_D, KC_MS_U)},
};

#endif
