PoringH/QCK75-XT/(commit log)

2023-02-23 Routing Adjustment, Pinout Change for I2Cs and also SWDIO & SWCLK
    [QCK.kicad_sch]
2023-03-02 PCB revision & Acrylic Case update
    [QCK-B_Cu.gbl, QCK-B_Mask.gbs, QCK-B_Paste.gbp, QCK-B_Silkscreen.gbo, QCK-Edge_Cuts.gm1, QCK-F_Cu.gtl, QCK-F_Mask.gts, QCK-F_Paste.gtp]
2023-04-13 CAD update
    [QCK.FCStd]
2023-05-16 created alu case design file
    [2mm_putih tulang_801.dxf, QCK.FCStd]
2023-06-09 Case update
2023-06-27 alu case update
    [bottomcase.step, topcase.step, weight.step]
2023-08-31 save firmwarey & Case update
    [QCK.FCStd, pcb.step, test.step]
